jim17/memtype/README.md

# Memtype
Open Source solution to store your passwords encrypted, having them available everywhere.
