jim17/memtype/documents/design/architecture.png

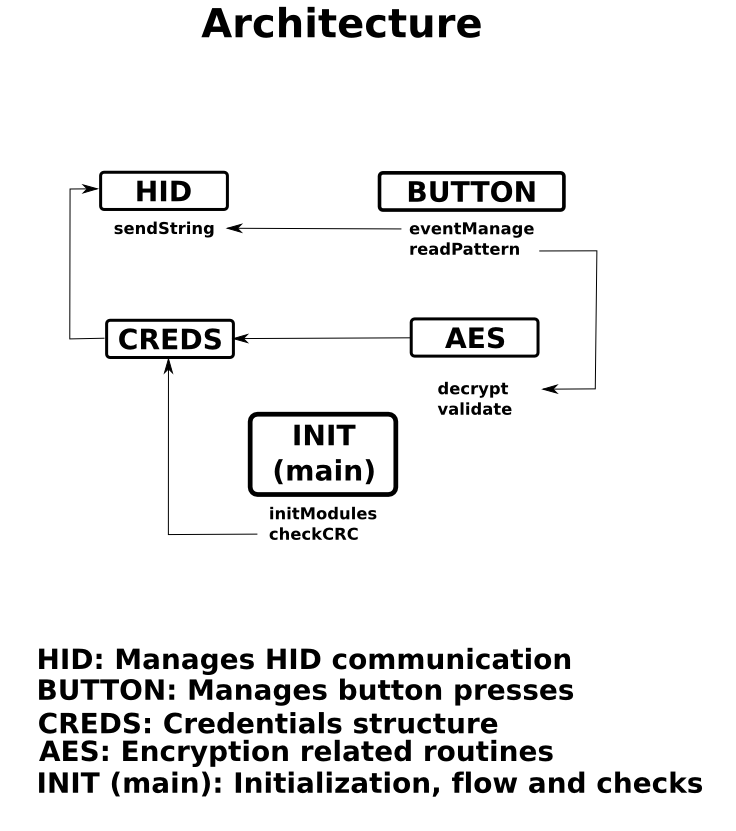
documents/design/architecture.png
