jim17/memtype/documents/design/flow.png

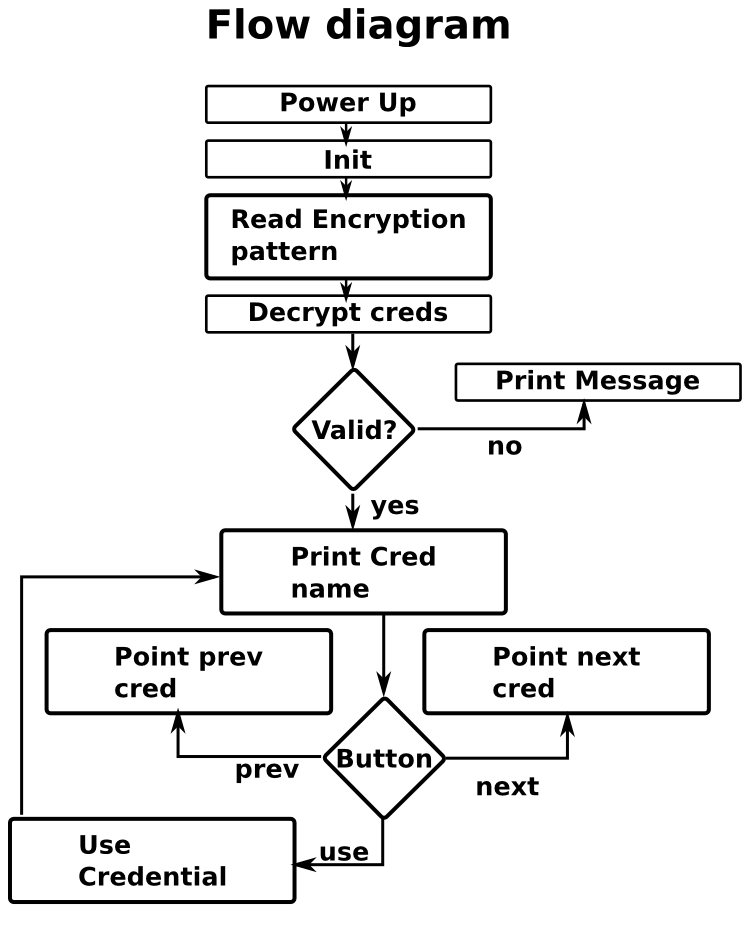
documents/design/flow.png
