jim17/memtype/documents/design/uif.png

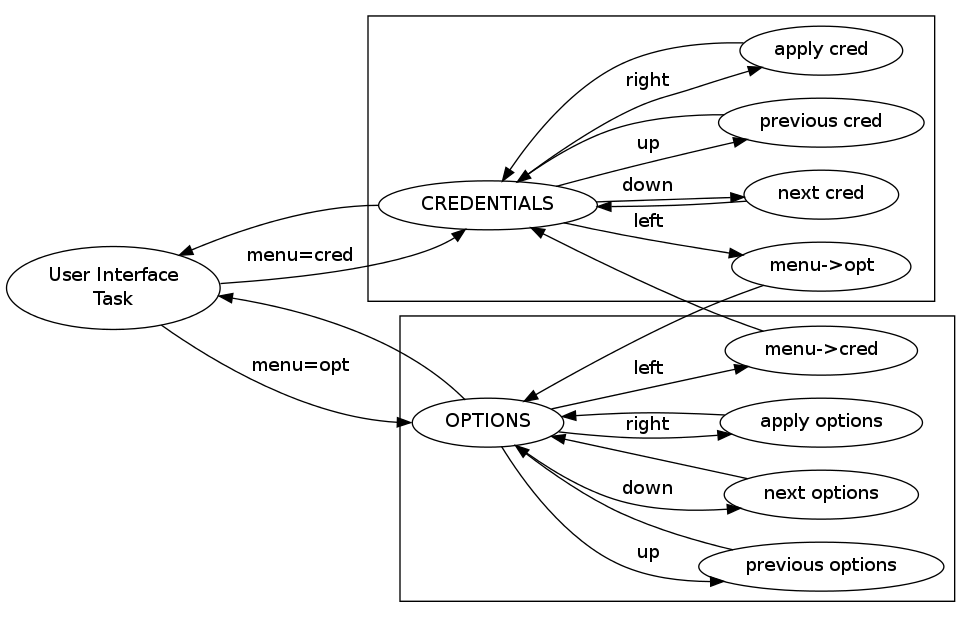
documents/design/uif.png
