jim17/memtype/documents/design/use_credential.png

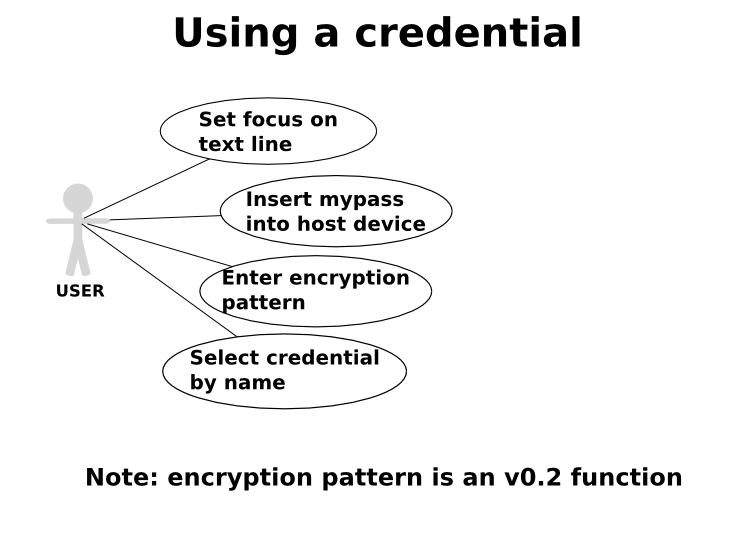
documents/design/use_credential.png
