jim17/memtype/documents/documentation/diagrams/hw.shaape.png

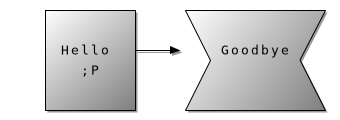
documents/documentation/diagrams/hw.shaape.png
