jim17/memtype/schematic_pcb/electronic_design_kicad/BOM/electronic_design_kicad.ods

Reference | Quantity | Quantity Total | Value | Footprint | Datasheet | mouser | Power
C1 | 1 | 35 | 100n | SMD_Packages:SMD-0805 |  | C0805C104K5RACTU
D1 | 1 | 35 | 3V6 | SMD_Packages:SOT-23 |  | AZ23C3V6-E3-08
IC1 | 1 | 35 | ATTINY85-S | SMD_Packages:SOIC-8 |  | 556-ATTINY85-20SU
P1 | 1 | 35 | USB | projectLib:usbA_std_pcb |  | 1-1734028-1
P2 | 1 | 35 | JOYSTICK | projectLib:JOYSTICK |  | SKQUAAA010
R1 | 1 | 35 | 1k5 | SMD_Packages:SMD-0805 |  | ERJ-6GEYJ152V | 1/8W
R2 R3 | 2 | 70 | 68R | SMD_Packages:SMD-0805 |  | ERJ-6GEYJ680V | 1/8W
R4 | 1 | 35 | 560k | SMD_Packages:SMD-0805 |  | ERJ-6GEYJ564V | 1/8W
R5 R6 R7 R8 | 4 | 140 | 1k | SMD_Packages:SMD-0805 |  | ERJ-6GEYJ102V | 1/8W
PCBs | 35
