jim17/memtype/schematic_pcb/electronic_design_kicad/SKQUAA.STEP

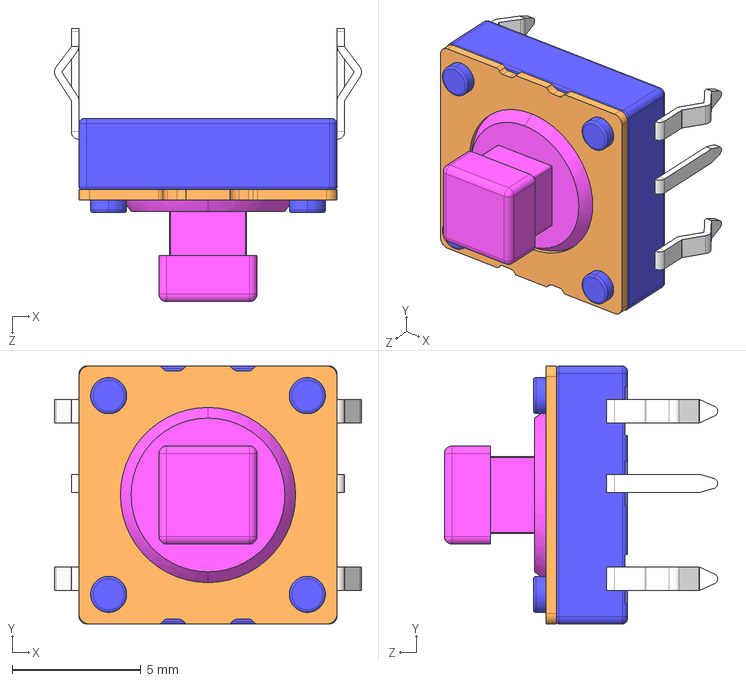
[picture p14: CAD file, 2015-10-31]
schematic_pcb/electronic_design_kicad/SKQUAA.STEP
11.9 x 10.0 x 10.6 mm
