jim17/memtype/(threads)

Thread 2 (2015-12-03):

MTTOOL has to decrypt strings on read from device.

oyzzo, 2015-12-03:
When reading the credential list from the device it's read using the encrypted strings.

jim17, 2015-12-04:
Added in https://github.com/jim17/memtype/commit/1b8994b55a74a11abfd41d5d97a975aeb8644f58 commit.

oyzzo, 2015-12-06:
Tested and It doesn't seem to decrypt properly.

oyzzo, 2015-12-06:
Tested on Linux works!
on MacOS X 10.11.1 doesn't work!
compiled with clang:
Apple LLVM version 7.0.0 (clang-700.1.76)
Target: x86_64-apple-darwin15.0.0
Thread model: posix

oyzzo, 2016-01-06:
It was caused by an unitialized variable. Solved on commit [develop 2d01f0f].

Closed 2016-01-06.

Thread 7 (2016-06-24):

Is there any limit to the number of bad PINs anyone can try?

pauser0000001, 2016-06-24:
Is the usb device protected against too many bad pins? how? I have not seen it in the documentation.

Incredible project, by the way.

oyzzo, 2016-06-24:
Hi @pauser0000001,
there's no limit for the moment, such a protection is indeed basic to be secure against brute force attacks.
A possible solution could be 3 bad pins resulting into full memory erase. What do you think?

pauser0000001, 2016-06-24:
As the pin guess is something that is not possible to do offline (unless the usb has been stolen), I think a less dramatic protection (to avoid to have to write the passwords in another media) could be also effective (if it is possible).
Only if possible, several pins could be needed in case of failure (configured at pin time creation).
After 3 bad pins, another pin is required (introduced by the owner at the time of pins creation).
The official library should advise the usb has been attacked and two or more pins are needed.
If the second pin is again now introduced 3 times, and the user configured another pin, then now 3 pins are needed (probable 3 pins are enough for everybody), otherwise do a full memory erase.
What do you think?

oyzzo, 2016-06-27:
ok, I've thinking about it and I think I've got it clear now.

Flash size limits us a lot on the firmware side, so every byte must be taken into account... that's why we implemented the NOEKEON in assembly for example. We need to keep as much space as we can free for password storage, and our target space was 2K, we're almost there :(

Protecting against PIN bruteforce attacks is a needed feature for sure. Now there're two options, the simple approach of erasing on 3 fails, or the more sophisticated one that you suggest.

From the flash size point of view, simple option wins.
From the security point of view, simple option wins too.

Now let's check if it could be a problem for some use case.

The 2 main use cases I can see are 1) a non professional use for personal credentials, and 2) a professional use for work credentials on cloud/servers/devices/webs/softwares etc...

In case you loose the credentials in use case 1) All software/webs/apps I can think of have the proper "forgotten password" option to easily solve it, so no big drama.

In use case 2) the export option of the GUI is highly recommended, to have a backup (encrypted!) of all credentials for all users. Relying on having the credentials in a single device is not a wise decision on a profesional environment.

pauser0000001, 2016-06-27:
Ok, simple option wins (with the encrypted backup in the GUI).
Best regards.

Closed 2017-10-10.

Thread 9 (2016-07-22):

ASCII Syn Chars?

dwhacks, 2016-07-22:
ASCII Syn Chars, what are they and how do we use them? I would like to add a wait for an SSH login.
Maybe this would be better added to the GUI as a list of usable/common keys for Hop and submit. Or a button to insert "waits".

oyzzo, 2016-07-22:
They are the '\s' character and each one adds a 500ms delay.
Using the GUI you can type \s and it will be translated just like \t is translated to tab key press, and \n is translated to an enter key.
For example you can create a ssh credential like following:
name: "Ssh machine1"
user: "ssh user@machine1.com -p 2222"
hop: "\n\s\s\s\s\s\s"
password: "passwordfor the machine1"
submit: "\n"

That will generate an enter and a 3 seconds wait before entering the password, and then another enter.

The quantity of \s has to be adjusted to be enough for your case. In my case local network ssh takes less time to ask for password than external internet ssh connections for example.

You're right about the usability improvement on the delay, we'll open an issue in the MemTypeTool GUI github to implement it.

Closed 2016-07-22.

Thread 10 (2016-07-27):

Loading OSCCAL from memory

s3c, 2016-07-27:
This is likely a stupid question but I'm asking it anyway, OSCCAL_Init is called to load the last calibrated OSCCAL value from memory when the unit powers on. When the unit initializes the value is however overwritten to restart the calibration process. Would it not be more effective to use the saved value instead?

jim17, 2016-07-28:
Well, after reviewing a bit the code, I think iit makes no sense to have the OSCCAL value stored in eeprom, as we are starting calibration process on every startup, the best aproach could be to remove the eeprom value and start the calibration process to have the most accurate value in that moment.

Regards,
Miguel.

s3c, 2016-07-28:
An alternative could be to save the value on the first run, and only do a boundary scan on each subsequent run. As temperature variations will have a slight impact, performing the boundary scan every time gives the best results with the least number of tries.

Closed 2016-08-07.

Thread 11 (2016-08-12):

3d printable case?

ec1oud, 2016-08-12:
I think it needs one.  Has anybody designed it yet?  If not, I might give it a shot.

oyzzo, 2016-08-13:
Hi @ec1oud you're right, a 3d printed case would be great!
For the moment nobody has designed one yet, if you feel like giving it a shot it'd be great.
If you need any kind of help from our side just ask.

We'll add links to it from the hackaday.io project, github and our blog web pages :)
Maybe adding the option to buy the memtype with a printed case could be interesting too.

What do you think?

ec1oud, 2016-11-16:
I made it; it works.  One downside is the PCB holes are so small that to mount the board in the case, I had to buy the tiniest bolts and nuts that I could find (1.2 mm).  But I would be able to print and sell them in small quantities, with the caveat that I hope I don't get too many complaints about how difficult it is to assemble because of needing such tiny bolts and nuts.

oyzzo, 2016-11-16:
Great! is there any photo of it?
Where are you selling them? we'll link it from our Tindie, hackaday.io and Documentation :)

ec1oud, 2016-11-21:
I didn't figure that out yet, but presumably I ought to use Tindie, right?

oyzzo, 2016-11-21:
It works for us :D So how can we get a couple of cases for testing? write us a mail at info @ area0x33.com and let us know how much and how long does it take for you to make them and send them. A couple of photos would be great too!

vimes79, 2017-02-24:
Hey guys. Did anyone design and create a 3D printable case for the memtype?
If so could you please post a link so I can print one off for my memtype.
Cheers

oyzzo, 2017-02-24:
hi @vimes79 !

well, @ec1oud was working on it, he passed us a photo and we wanted to buy him some units to test them but we got no response. No files were published by him as far as we know.

We'd like to find a case but we don't have any 3D printer or knowledge.
We tried with some standard usb cases but there was no way of fitting the joystick into them.

Any help on this subject would be more than welcome :D

vimes79, 2017-02-24:
I was just wondering if anyone had already got a design that I could just
print out.

Since there isn't an existing design, I will happily get something CAD
modelled tonight and take it down to my small workshop over the weekend
where I will try a few ideas out...

I have several 3D Printers of varying size and quality as well as 2 laser
cutters and a mini desktop CNC mill as well as most other tools/materials
you would need in a workshop where prototypes are born and small production
runs of various things can be made (which is what i do as a hobby/2nd Job
in my spare time!). I will take my memtype down there this weekend and see
what I can come up with, either printed, milled or cut & engraved.

I will keep you updated here and put links to photos and all the files once
I have something tidy that works!

Cheers
Nial

At Hashing UK. Messages sent are from N.P. and are my opinion and should
not be quoted in public domain. This is sent from my Samsung Galaxy S6 Edge
+
---Please support Open Source Hardware and Software---

On 24 Feb 2017 14:42, "Noel Carriquí Ojeda" <notifications@github.com>
wrote:

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

ec1oud, 2017-02-24:
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

I’m in Norway, so I’m afraid the shipping costs might be more than it’s worth.  I should try to ship one to someone to find out how much it costs, though.

I can print more of them, but I needed to use the world’s smallest bolts (1.2mm I think it was) to fit through the tiny holes on the PCB while holding it closed.  And then assembly is a bit tricky because of that too.

I have extra bolts, so I could ship a complete kit, actually.

oyzzo, 2017-02-24:
@vimes79  Perfect! we look forward to see the results. It'd be nice to provide a MemType + case option so anyone can buy it together :)

@ec1oud you're right, shipping cost are important. let us know how it all evolves ;)

primetoxinz, 2017-05-12:
Any info on a design for this? I have access to a 3d printer and I would like to print a case for my memtype

jim17, 2017-12-10:
No case available, it would be good if you can make one

Yury-MonZon, 2017-12-10:
I'm designing the case at the moment. Didn't print it yet.
Will try to test fit it in a few days and report back.
Here are some CAD screenshots:
https://ibb.co/hsGbcw
https://ibb.co/kxfPVG

Yury-MonZon, 2017-12-11:
Printed the case:
https://ibb.co/jNBHkG
https://ibb.co/bxhZXw

Need to adjust it a tiny bit more for the perfect fit.

oyzzo, 2017-12-12:
@Yury-MonZon great job!
keep us updated on the progress.  A lot of memtype users would like to have a case, including me :)

Yury-MonZon, 2017-12-13:
I think I've done it. I'll send you the files via e-mail. I did print it using black PLA, but would be much cooler to print it in transparent. Next time, when I'll change the plastic, I'll print one or two.

Yury-MonZon, 2017-12-13:
Here is the thingiverse page https://www.thingiverse.com/thing:2710925
Transparent plastic + also I've edited some tolerances.
Enjoy!

oyzzo, 2017-12-13:
@Yury-MonZon great!
I've uploaded all the files in a zip file to the master branch.

Great work!

Closed 2017-12-13.

Thread 12 (2016-10-14):

Different pin input method suggestion

nukeportugal, 2016-10-14:
Instead of a base 10 pin with 4 digits where you have to press up or down to change the current digit, use a base 4 pin with 8 digits where each direction in the joystick represents a number. This would present a few advantages:
* Pin entry would always be a constant 8 steps instead of 4 to 24 steps (pin 0000 or pin 5555)
* Will result in more pin combinations (4^8 = 65536 vs 10^4 = 10000)
* Makes it easier to input the pin without looking at the screen (maybe even make it type "pass: " and fill with asterisks as you input the pin or blink a led for every digit)

What do you think?
Great project by the way.

oyzzo, 2016-10-15:
Hi @nukeportugal!

Thanks for your comment!

We took that approax into account when designing the pin validation at the very beginning of the project, you are right in the 3 "pros" that you write in favor of using base 4 pin.

The main reason was that the human brain is way better remembering a small 4 digit decimal number than a longer series of joystick directions. You are right that we've got 10K combinations instead of 65K, but that's the same order of magnitude and doesn't make any difference in case of memory dump and brute force attack, using more digits would, but it'd imply using too long to remember PINs in any base.

One of the mains goals of the MemType device is to be easy to use, and the main security point on it is having it phisically with you, in case of loss a reasonable amount of security is needed, but keeping in mind it can not add too much difficulty of use or it'll be useless because nobody will use it.

We're currently working on a more professional focused version from scratch with a totally different core that will allow us to improve capacity, security, usability and with more features.

Closed 2016-10-15.

Thread 13 (2016-10-16):

Hardware improvements

12458, 2016-10-16:
Could you please implement
 - capacitive touch option
 - internal pull up for the ADC

jim17, 2016-10-16:
Hello we are developing new hardware version with different microcontroller with the idea to include capacitive touch buttons.

As you can imagine hardware changes are more difficult to be done than SW changes, what's the reason of using the internal pull up ? It just save us one resistor !!

Thank for your comments,
Regards,
Miguel.

12458, 2016-10-16:
"As you can imagine hardware changes are more difficult to be done than SW changes, what's the reason of using the internal pull up ? It just save us one resistor !!"
Well, it can save precious board space for people building it themselves.(dip components)
How hard is it to implement a internal pull up. Maybe implement it in the next hardware rev.

"Hello we are developing new hardware version with different microcontroller with the idea to include capacitive touch buttons."
I thought it can be done with a AVR.
http://www.atmel.com/products/TouchSolutions/bsw/qtouch.aspx

12458, 2016-10-16:
Another solution is to add a config menu so we can change the features according to our needs.

jim17, 2016-10-16:
Hello,

As we are planning a new board revision with different microcontroller, I think the pullup idea makes no sense.

The current flash usage of the attiny85 is 100% si if we plan to any new component like a capacitive IC it will increase device price and flash usage, so there will be less space for credential storage.

I don't see the point of the configuration menu, and I don't think any open source project has something like this.

The components we will use now, and in a future will be SMD as DIP components increase the PCB size and it would be impossible to obtain an USB form factor using DIP components.

Regards,
Miguel.

12458, 2016-10-16:
Well I guess the changes to the software is too much for a resistor.
Thank you for answering my questions

As for another open source project using build menus, those are huge project with many contributors.

BTW: You might want to consider the STM32F103
It has native full USB support and quite a bit of flash. It is relatively inexpensive also.

Closed 2016-10-16.

Thread 16 (2017-10-10):

Secondary pin

Yury-MonZon, 2017-10-10:
It would be cool to have the secondary pin in case the owner is attacked physically. When this pin in entered all the data could be erased and/or dummy credentials would be given.

oyzzo, 2017-10-10:
hi @Yury-MonZon ,

Thanks for your feedback!

In case of physical brute force attack, when he PIN is missed few times, all the credentials are lost and pin restored to 0000.

Does it solve the case you are describing?

Yury-MonZon, 2017-10-10:
Thanks for the fast response.
Not exactly,
another PIN with a few dummy passwords could lead attackers to fake account/cloud etc...

oyzzo, 2017-10-10:
So you mean adding a secondary PIN that leads to a fake credentials group?

Yury-MonZon, 2017-10-10:
Yes!

oyzzo, 2017-10-10:
Aha, I understand now!

We use a low cost microcontroller and that means strong limitations, one of the harder being space, there is no flash space left to implement any other feature.
We'd like to have also a bootloader to allow firmware updates and some other more general features first, but we've reach the limit were we can only fix bugs and nothing else.

Anyway being it opensource anyone is free to use a bigger microcontroller or some external memory and implement any other desired feature.

Yury-MonZon, 2017-10-12:
I've figured out the way to add the second (erase) pin and it still fits into the chip. Tell me if you need the code.

jim17, 2017-10-13:
Hello,

Yes, we would like to  have this feature !! Create a pull request from github and we will introduce the code, comment if changes are needed and so on.

Regards,
Miguel.

Yury-MonZon, 2017-10-14:
Added. Let me know what do you think.

Closed 2017-10-10.

Thread 17 (2017-10-10):

USB plug

Yury-MonZon, 2017-10-10:
Instead of ordinary full-blown USB plug we could have PCB version of it. Like the ones on the Digispark.

oyzzo, 2017-10-10:
hi @Yury-MonZon,

Thanks for your feedback!

We had that on the first version but we added a proper full-blown USB connector as it provides a better connection and support.

Closed 2017-10-10.

Thread 18 (2017-10-11):

KiCad files not updated to the latest version

Yury-MonZon, 2017-10-11:
I'm having a problem with PCB files - the KiCad project seems to be different from the board you have in gerbers.zip. Probably, you didn't update the KiCad files?

jim17, 2017-10-11:
Hello,

gerber.zip was created from this commit:
https://github.com/jim17/memtype/tree/e36160c6a7bb98c71b21bb8811069e193ff50bab

So, yes gerbers.zip not updated with version 3.0.0 of the hardware (but it was just a test and its not the board present on tindie).

Pick kicad files from this commit:
https://github.com/jim17/memtype/tree/e36160c6a7bb98c71b21bb8811069e193ff50bab

Regards,
Miguel.

Yury-MonZon, 2017-10-11:
I see you've omited resistor and capacitor on usb's vcc, what is the reason behind it?

jim17, 2017-10-11:
Because I think it was added later on on:

https://github.com/jim17/memtype/tree/9df4448dbc72639fe937b70f58c2509878bb398e

Regards,
Miguel.

Closed 2017-12-10.

Thread 20 (2017-11-25):

The printed board does not work！

getwjx, 2017-11-25:
Hello，I can not find the code with the full PCB file, I can not print the version and matching code,
Can you give me a matching photo file and code?thank you very much!I tried different code, but can not use, can you help me?

getwjx, 2017-11-25:
I tried different code, but can not use, can you help me?

jim17, 2017-12-10:
Hello, kicad project is present, you can generate the gerber files by your own.

Regards,
Miguel

Closed 2017-12-10.

Thread 21 (2017-12-06):

Pin reset issues

Yury-MonZon, 2017-12-06:
Actually, the pin resets itself after 4 wrong tries (not after 3!). And after it got reset to 0000 I can see all my previous names of the credentials. The passwords are destroyed though. Bug? =)

Closed 2017-12-12.

Thread 22 (2018-03-25):

Issues with latest pcb revision

BRFud, 2018-03-25:
Hi. I really like this project, thank you for making it.

The latest pcb revision I can find in the repository is ```memtype/schematic_pcb/electronic_design_kicad/memotype.pretty/electronic_design_kicad.kicad_pcb```

But when I open this in Pcbnew I see some components are not yet connected (there is some "ratsnest"), also I can find no associated schematic file for this revision.

It would really help if we had sorted the hardware schematic/pcb and BOM into separate directories in "/schematic_pcb" for each hardware revision.

And do I understand correctly the gerber files currently in the repository are only older square revision with only 1 LED?

Thanks!

jim17, 2018-03-25:
Hi, you can find the latest pcb revision in:
https://github.com/jim17/memtype/releases

Regards,
Miguel.

BRFud, 2018-03-27:
I did not expect the master repository the be behind the release. Thanks for pointing me to the right files.

Closed 2018-03-27.

Thread 24 (2018-08-02):

Lost PIN

Basti77, 2018-08-02:
I did not use the stick longer and forgot the PIN.
how can I return the stick to the delivery state?

that the passwords are gone does not matter.

jim17, 2018-08-06:
Hello,

Depends on the version you have. From version 3.2.0 the 4 failures in the password, reset it to pin 0000.

Regards,
Miguel.

Closed 2018-12-04.
