jim17/memtype/schematic_pcb/electronic_design_kicad/electronic_design_kicad.pdf

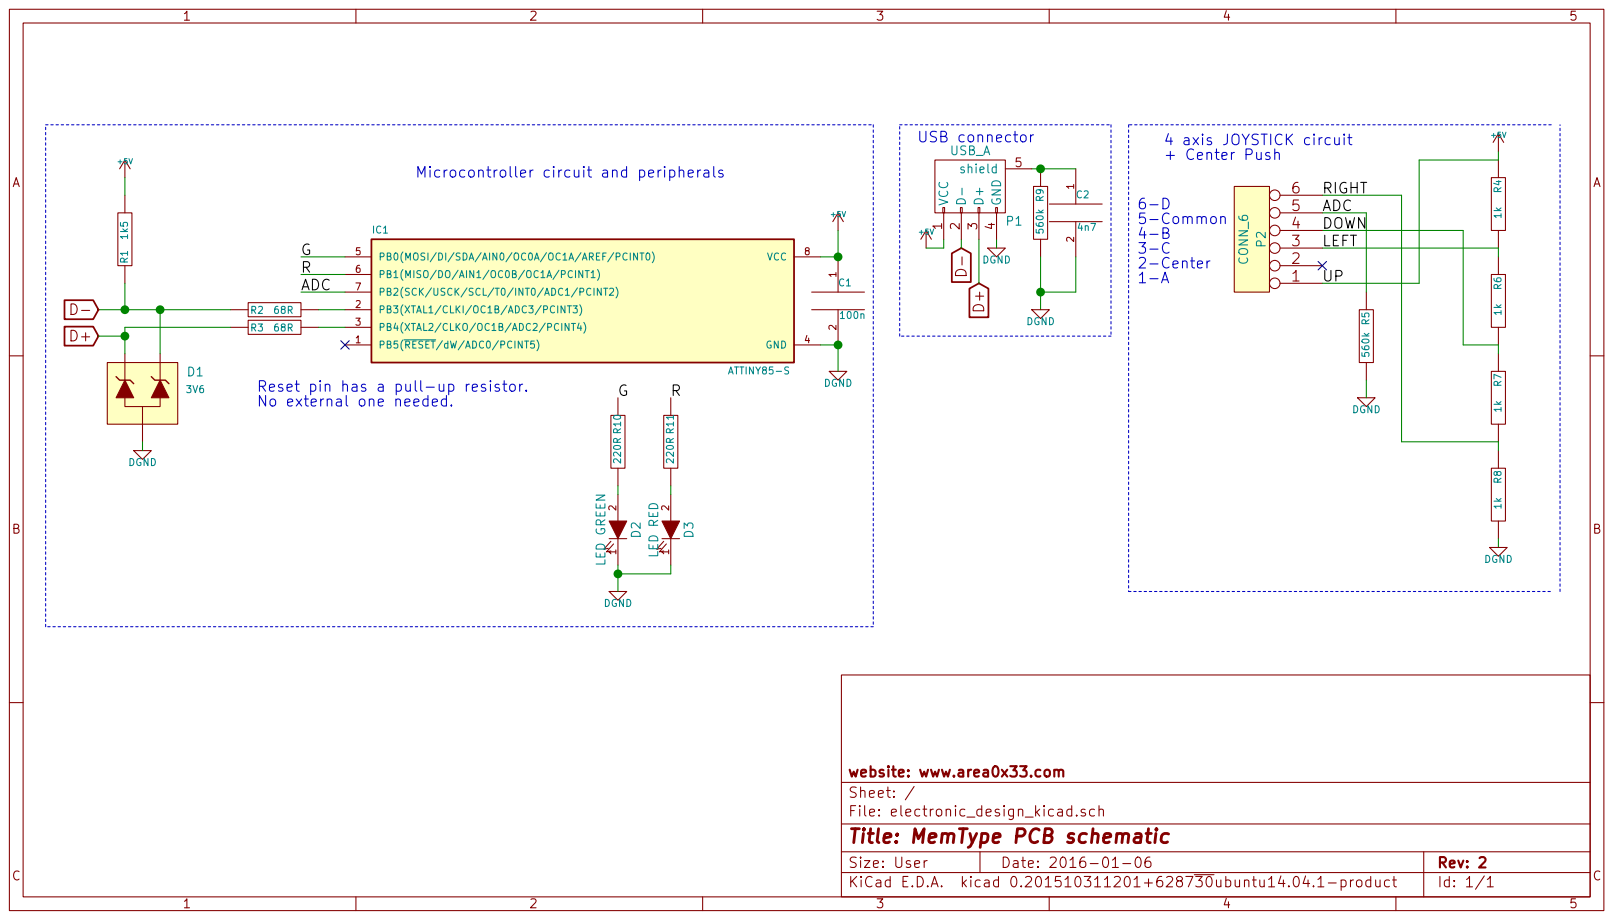
[picture p22: page 1]

Microcontroller circuit and peripherals D1

Reset pin has a pull-up resistor. No external one needed.

File: electronic_design_kicad.sch Sheet: / website: www.area0x33.com

Id: 1/1 Title: MemType PCB schematic
