jim17/memtype/schematic_pcb/electronic_design_kicad/electronic_design_kicad.kicad_pcb

## KiCad design schematic_pcb/electronic_design_kicad/electronic_design_kicad.kicad_pcb (2016-06-27)

Schematic: electronic_design_kicad.sch, MemType PCB schematic

Parts:
C1: 100n; SMD-0805; mouser C0805C104K5RACTU
C2: 4n7; SMD-0805; mouser C0805C472K5RACTU
D1: 3V6; SOT-23; mouser AZ23C3V6-E3-08
D3: LED RED; LED_0603_PIPE; mouser Q976-NR-1
IC1: ATTINY85-S; SO8_200mil_wide; mouser 556-ATTINY85-20SU
P1: USB_A; USB_A_MALE; mouser 534-932
P2: CONN_6; SKRHAAE010; mouser SKRHAAE010
R1: 1k5; SMD-0805; mouser ERJ-6GEYJ152V
R2, R3: 68R; SMD-0805; mouser ERJ-6GEYJ680V
R4, R6, R7, R8, R12: 1k; SMD-0805; mouser ERJ-6GEYJ102V
R5, R9: 560k; SMD-0805; mouser ERJ-6GEYJ564V
R11: 220R; SMD-0805; mouser ERJ-6GEYJ221V

Connections:
+5V: C1.1, IC1.8 (VCC), P1.1, P2.1, R1.1, R4.1
/ADC: IC1.7 (PB2(SCK/USCK/SCL/T0/INT0/ADC1/PCINT2)), P2.5, R5.1
/CENTER: P2.2, R8.2, R12.1
/DOWN: P2.4, R6.2, R7.1
/LEFT: P2.6, R7.2, R8.1
/R: IC1.6 (PB1(MISO/DO/AIN1/OC0B/OC1A/PCINT1)), R11.1
/UP: P2.3, R4.2, R6.1
D+: D1.2 (K), P1.3, R3.1
D-: D1.1 (K), P1.2, R1.2, R2.1
DGND: C1.2, C2.2, D1.3 (A), D3.1, IC1.4 (GND), P1.4, R5.2, R9.2, R12.2
unnamed: C2.1, P1.5, R9.1
unnamed: D3.2, R11.2
unnamed: IC1.2 (PB3(XTAL1/CLKI/OC1B/ADC3/PCINT3)), R2.2
unnamed: IC1.3 (PB4(XTAL2/CLKO/OC1B/ADC2/PCINT4)), R3.2

Notes on the sheet:
4 axis JOYSTICK circuit + Center Push
USB connector
Microcontroller circuit and peripherals
6-D 5-Common 4-B 3-C 2-Center 1-A
Reset pin has internal pull-up resistor. No external one needed.

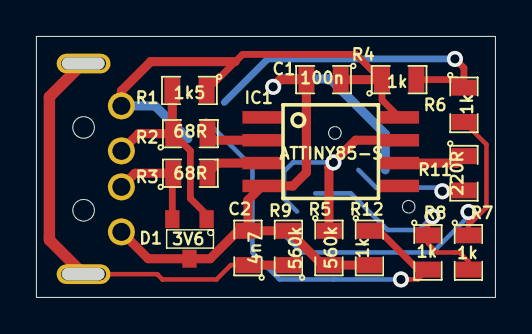
[picture p23: board electronic_design_kicad.kicad_pcb from above]

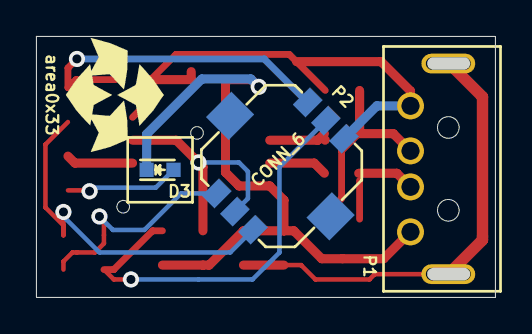
[picture p24: board electronic_design_kicad.kicad_pcb from below]

Board: 2 copper layers, 25.5 x 14.5 mm, 19 parts (4 on the bottom side), 14 nets.

Other parts of the board:
area0x33: LOGO; logo
