jim17/memtype/(commit log)

2015-10-31 Version 3.0.0
    [SKQUAA.STEP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]
2015-10-31 Added missing function prototypes that causes clang to error
2015-11-29 changed VID and PID to the one obtained in http://pid.codes/pids/
2015-12-06 revert back usbconfig and crd files
    [crd.h, usbconfig.h]
2016-01-19 first steps to memtype revision 2 pcb
2016-02-01 added 3d design files and finished schematic and PCB
    [electronic_design_kicad.csv, electronic_design_kicad.kicad_pcb, electronic_design_kicad.sch]
2016-02-02 added gerber files for manufacture
    [electronic_design_kicad-B.Cu.gbr, electronic_design_kicad-B.Mask.gbr, electronic_design_kicad-B.SilkS.gbr, electronic_design_kicad-B_Cu.gbl, electronic_design_kicad-B_Mask.gbs, electronic_design_kicad-B_SilkS.gbo, electronic_design_kicad-Edge.Cuts.gbr, electronic_design_kicad-Edge_Cuts.gbr]
2016-02-06 changed internal RC calibration calibration routine, seems to fix bad behavior during enumeration in some USB with lot of bus activity
    [main.c, osccal.c, usbconfig.h]
2016-02-06 add PDF plot of electronic design hardware rev2
    [electronic_design_kicad.sch]
2016-02-08 added make check for code formatting with uncrustify
    [style.cfg]
2016-04-26 memtype hardware revision 2.1
    [electronic_design_kicad-B.Cu.gbr, electronic_design_kicad-B.Mask.gbr, electronic_design_kicad-B.SilkS.gbr, electronic_design_kicad-Edge.Cuts.gbr, electronic_design_kicad-F.Cu.gbr, electronic_design_kicad-F.Mask.gbr, electronic_design_kicad-F.SilkS.gbr, electronic_design_kicad.drl]
2016-04-27 update joystick direction in schematic and code
    [electronic_design_kicad.kicad_pcb, electronic_design_kicad.sch]
2016-05-05 fix synchronous delay bug
    [print.c]
2016-05-17 added DETAIL led blink feature
2016-06-19 hardware revision 3.0
    [electronic_design_kicad-B.Cu.gbr, electronic_design_kicad-B.Mask.gbr, electronic_design_kicad-B.SilkS.gbr, electronic_design_kicad-Edge.Cuts.gbr, electronic_design_kicad-F.Cu.gbr, electronic_design_kicad-F.Mask.gbr, electronic_design_kicad-F.SilkS.gbr, electronic_design_kicad.drl]
2016-06-26 LOCK device after SET PIN command fix #1
    [opt.c, ucp.c, uif.c]
2016-06-26 bumped to version 3.1.1 fix #1
    [version.h]
2016-07-19 fix #3 - Bumped to version 3.2.0, PIN hide pin numbers except the one being writted
    [ucp.h, usi.c, version.h]
2016-12-18 renaming of LED macros
2017-01-19 added 3 pin erroneous entries before reseting the pin back to 0000
    [usi.c]
2017-12-12 Added Erase PIN and it's corresponding message (#19)
    * Update usi.c
    Added Erase Pin functionality
    line 9: Fixed pin retries to 3 instead of 4
    [usi.c]
2017-12-13 Added the MemType 3D case. Made by Yury MonZon.
2018-04-24 Workaround for KEY_EUROPE_2 (#23)
    [Keyboard-layouts.ods]
2024-02-02 Fixed the start value byte. (#26)
    [led.c]
